JanBirchDK/Overkorsel-Station-Enkeltsporet/hardware/Breadboard.pdf

# Overkørsel st. enkeltsporet strækning

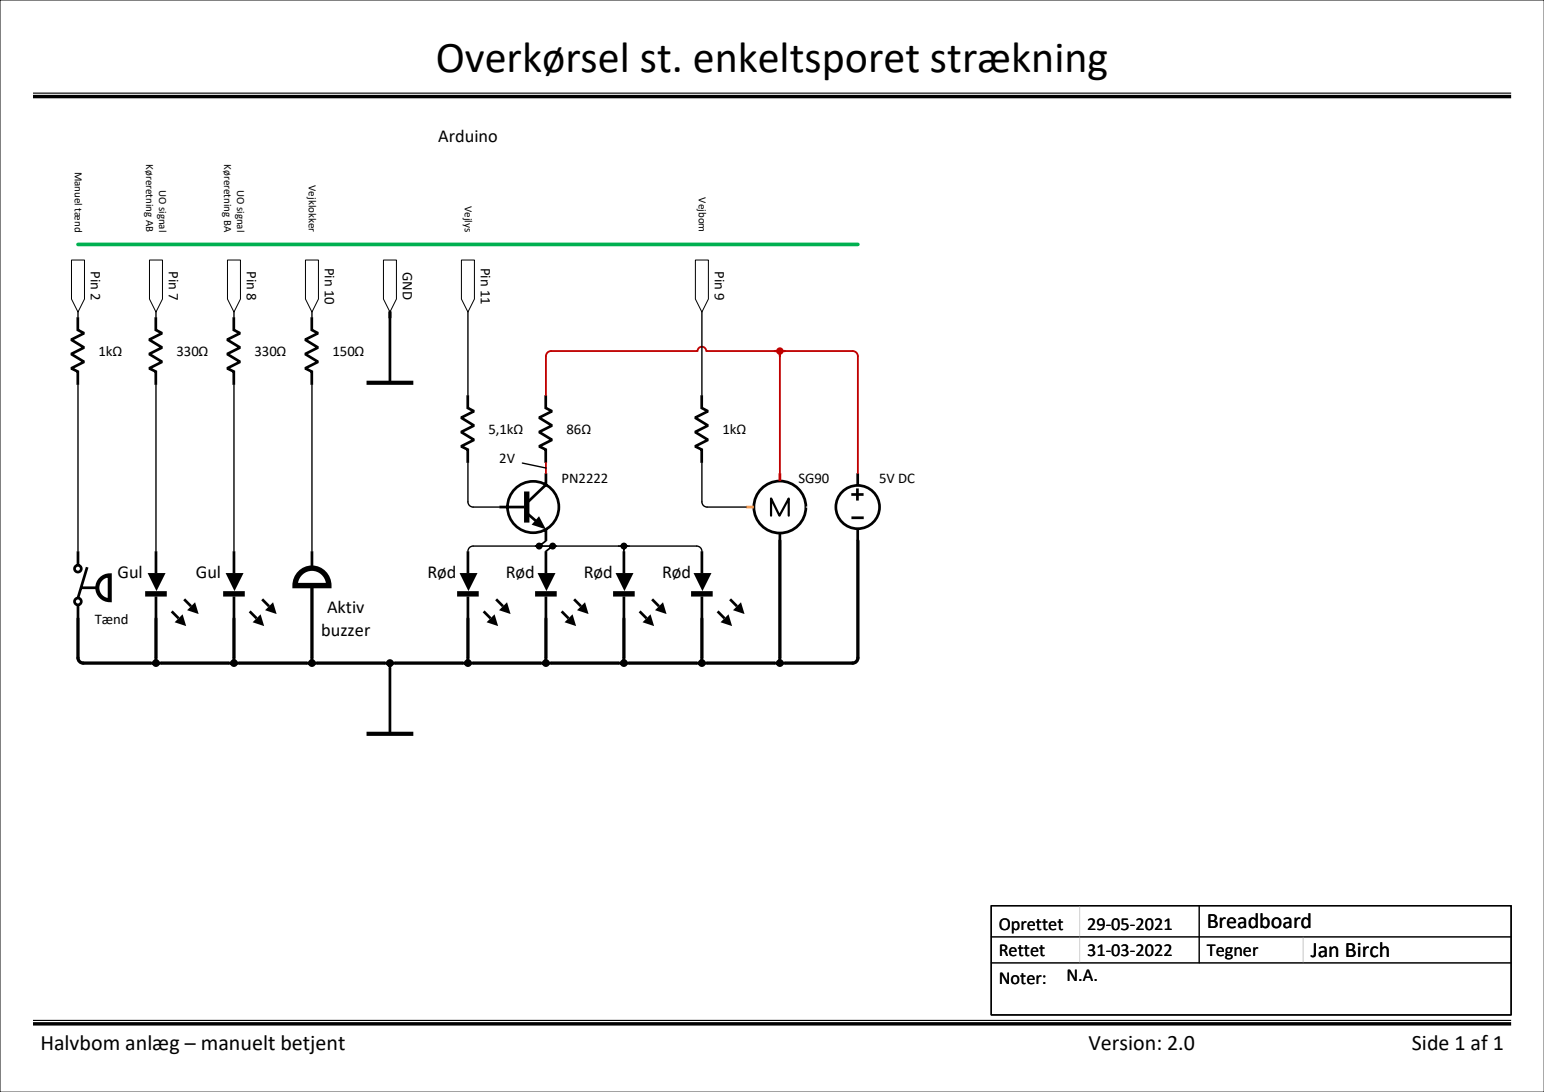
[picture p2: page 1]
Halvbom anlæg – manuelt betjent; Version: 2.0; Side 1 af 1; Oprettet; Rettet; Tegner; Noter: N.A.; Breadboard Jan Birch; Manuel tænd; Arduino; UO signal; Køreretning AB; Pin 2; Gul; Tænd; Aktiv buzzer; Pin 7; Køreretning BA; Pin 8; Vejklokker; Pin 10; GND; Pin 11; Rød; Vejlys; Pin 9; Vejbom
