JanBirchDK/Overkorsel-Station-Enkeltsporet/Tilstandsdiagram.pdf

# Overkørsel st. enkeltsporet strækning

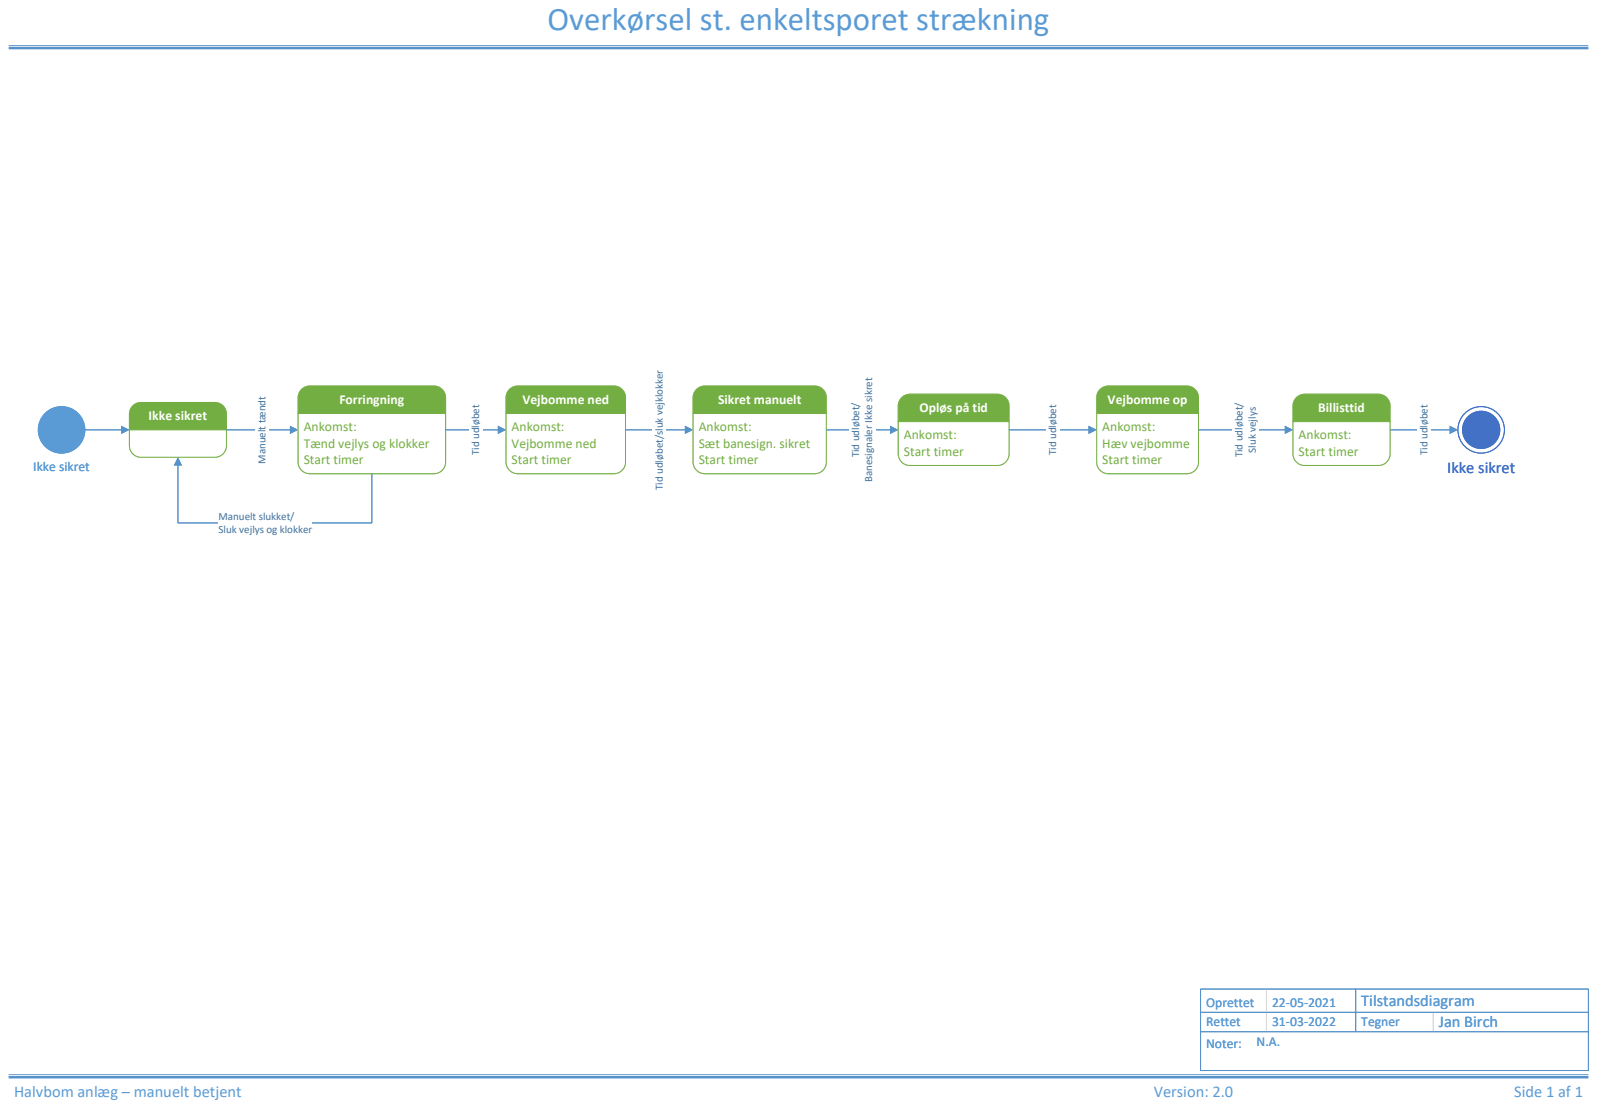
[picture p3: page 1]
Halvbom anlæg – manuelt betjent; Version: 2.0; Side 1 af 1; Oprettet; Rettet; Tegner; Noter: N.A.; Tilstandsdiagram Jan Birch; Ikke sikret; Vejbomme op; Ankomst: Hæv vejbomme Start timer; Vejbomme ned; Ankomst: Vejbomme ned Start timer; Billisttid; Ankomst: Start timer; Manuelt tændt; Forringning; Tid udløbet; Sikret manuelt; Tid udløbet/; Sluk vejlys

Tid udløbet/sluk vejklokker

Banesignaler Ikke sikret

Opløs på tid

Ankomst:
Tænd vejlys og klokker
Start timer

Sæt banesign. sikret

Manuelt slukket/
Sluk vejlys og klokker
